Llamero/Dual_laser_controller-Arduino/Images/Box - top.jpeg

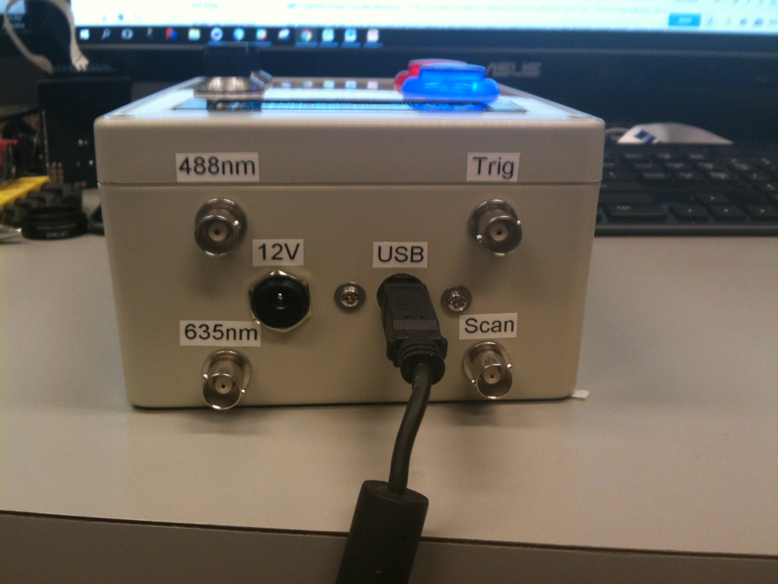
Images/Box - top.jpeg
