Llamero/Dual_laser_controller-Arduino/Images/Proto board - top.jpeg

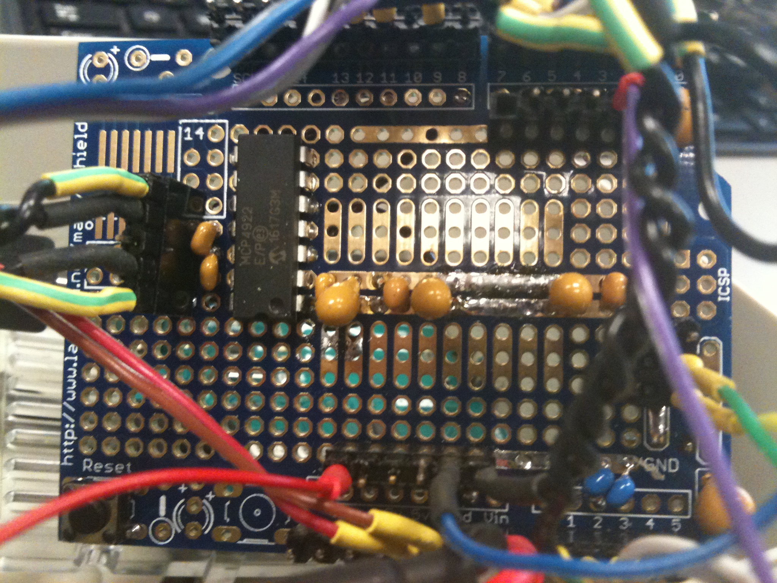
Images/Proto board - top.jpeg
