Llamero/Dual_laser_controller-Arduino/Images/Box - front.jpeg

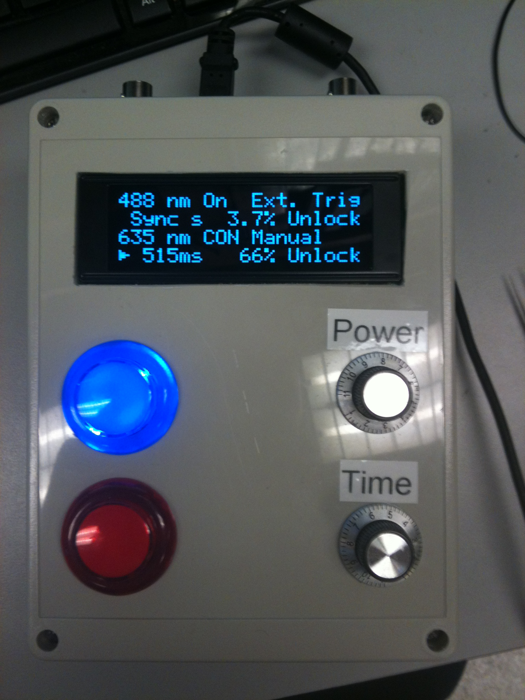
Images/Box - front.jpeg
