Llamero/Dual_laser_controller-Arduino/Images/Laser toggle fritzing_bb.png

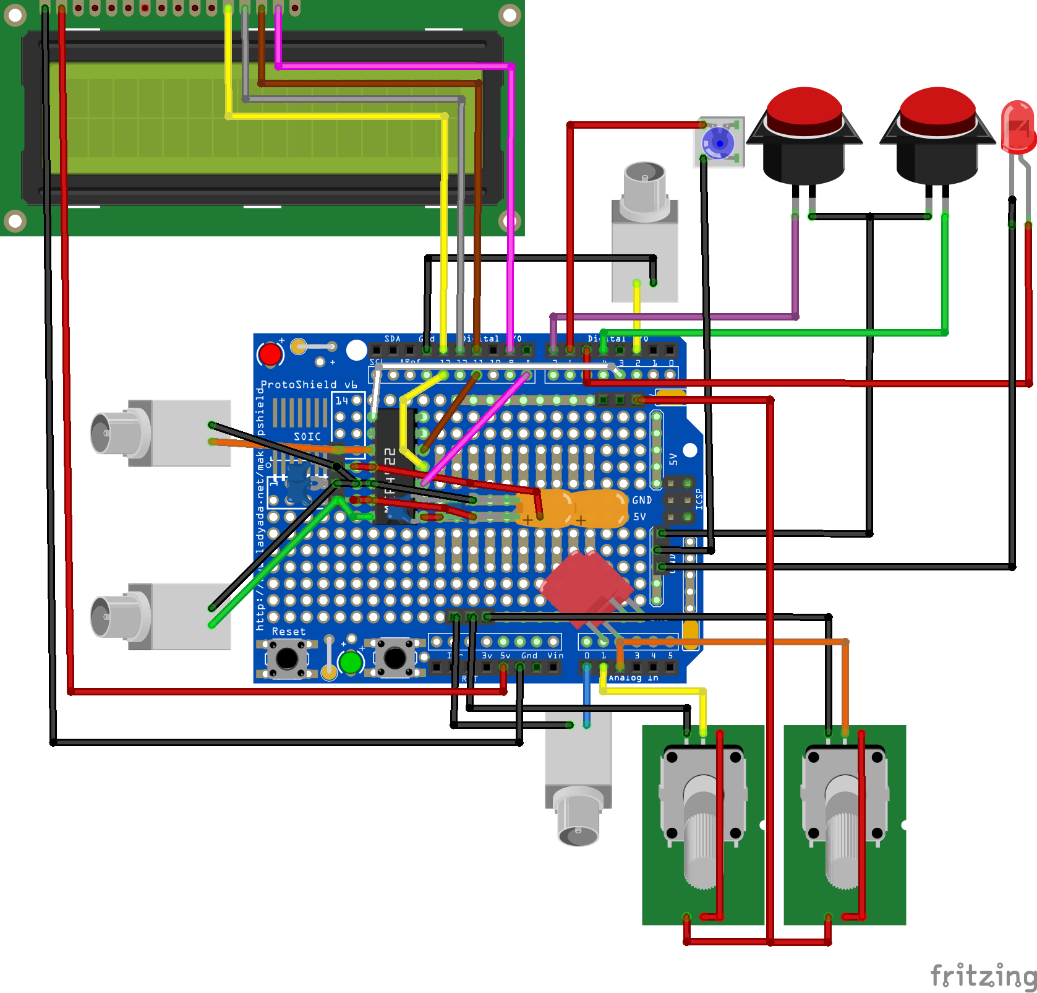
Images/Laser toggle fritzing_bb.png
