Llamero/Dual_laser_controller-Arduino/Images/Laser toggle fritzing_schem.png

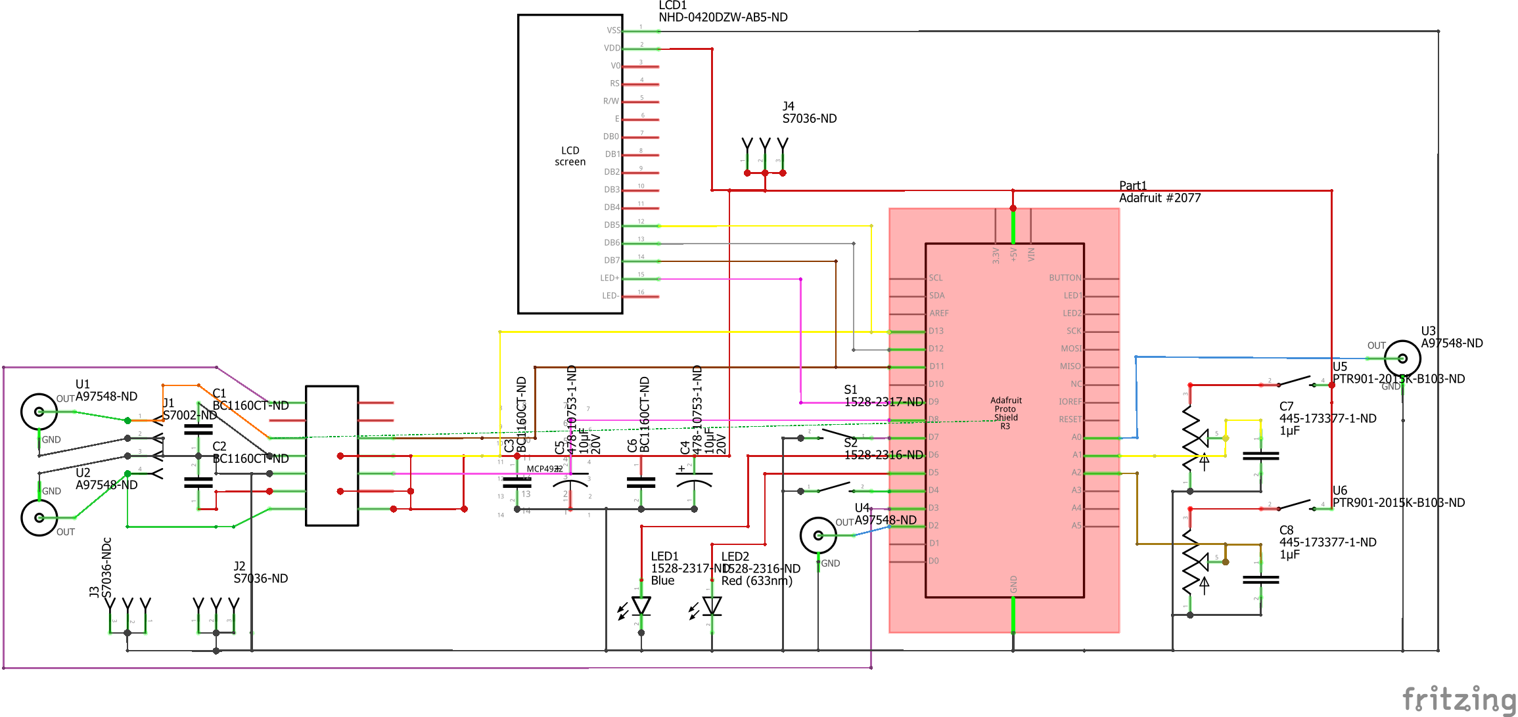
Images/Laser toggle fritzing_schem.png
