Llamero/Dual_laser_controller-Arduino/Images/Lid - back side.jpeg

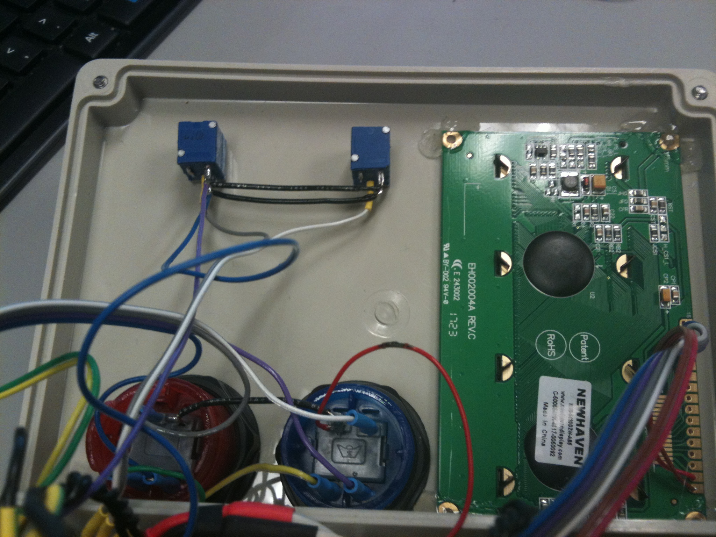
Images/Lid - back side.jpeg
