Llamero/Dual_laser_controller-Arduino/Images/Proto board - bottom.jpeg

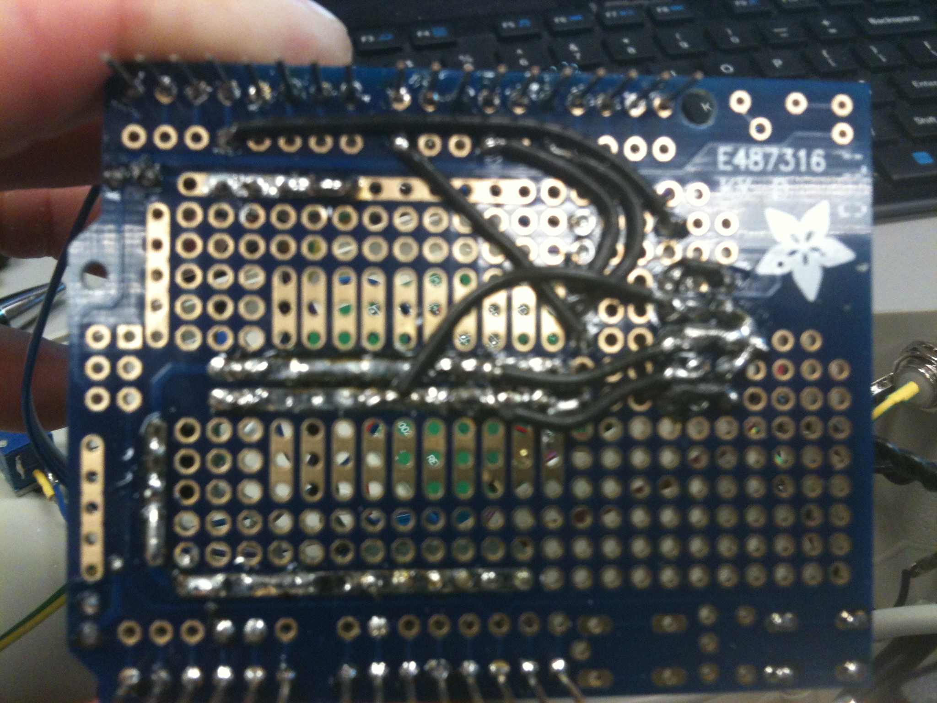
Images/Proto board - bottom.jpeg
