Llamero/Dual_laser_controller-Arduino/(list of files, drawings)

Other design files:
Fritzing schematic/Laser toggle fritzing.fzz
