Llamero/Dual_laser_controller-Arduino/(commit log)

2018-02-15 Added all inputs
    NOTE: try swtich case on modes list with single mode variable
2018-02-21 Added schematic and pictures
    [Laser toggle fritzing.fzz, Pin assignments and display.xlsx]
2018-02-21 Added BOM
    [Parts list (BOM).csv]
2018-03-10 Oranized files
    [Laser toggle fritzing.fzz, Pin assignments and display.csv]
2018-03-10 Improved organization
    [Laser toggle fritzing.fzz, Pin assignments and display.xlsx]
2018-03-19 Added manual, updated arduino code
